josephch50/Wireless-Oscilloscope/0_Documentation/Oscilloscope Captures/Oscilloscope.jpg

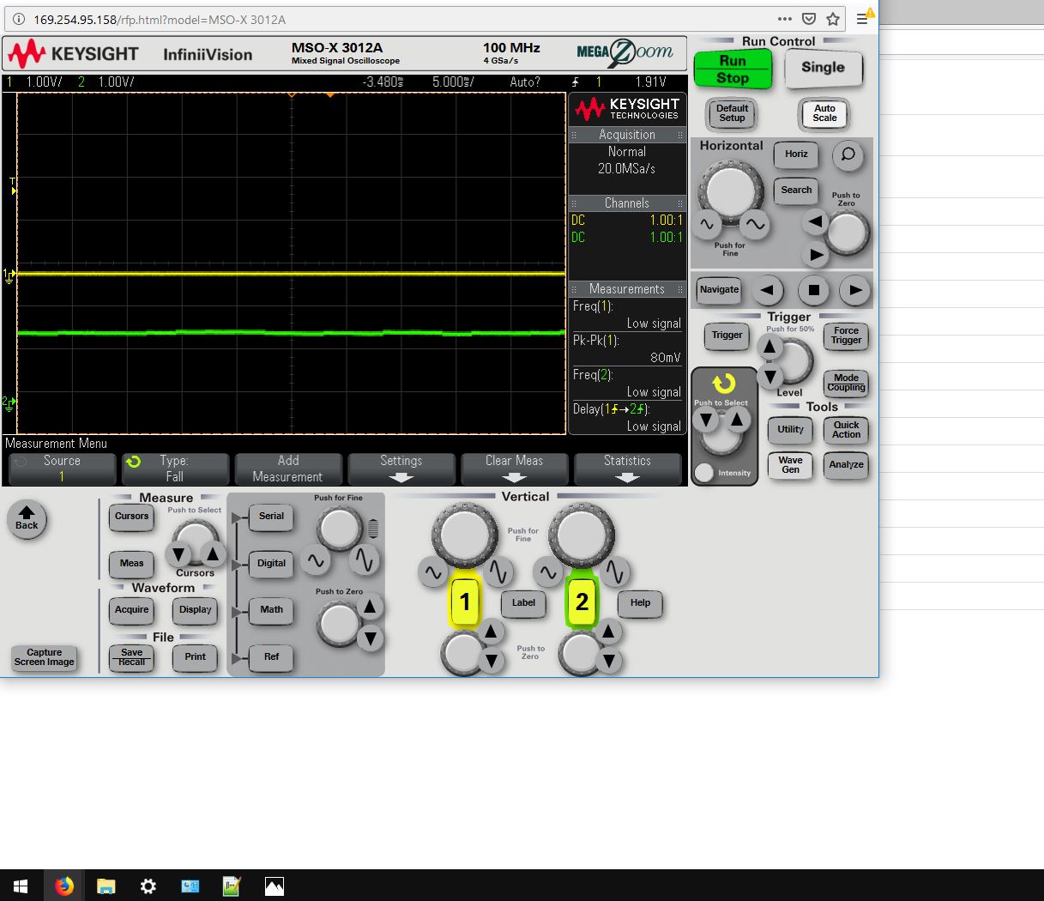
0_Documentation/Oscilloscope Captures/Oscilloscope.jpg
