josephch50/Wireless-Oscilloscope/README.md

# Wireless-Oscilloscope
Creating a wireless oscilloscope comprising of two TI MSP430F2274 development boards and AD5320 DAC

## Embedded Systems
## Team: Scope-A
## Contributors: Joseph Chen, Samuel Solverson, Andrew Kirkum

### Project Overview
The project will consist of building a Wireless Remote Oscilloscope Probe that uses two eZ430 cards, one for measuring the analog input signal and the other for reconstructing the analog signal using a digital to analog converter. As noted on the Final Project Specification[1] handout, the conditions for testing functionality include:
- Measure An input analog signal voltage ranging from 0 V to 3 V
- Input test signals of both sinusoidal and square waveforms
- Captures of both original and reconstructed signals on an oscilloscope
- A report, analyzing the performance of our project, including:
	- The lag time between the signals due to wireless system performance
	- The accuracy of the reconstructed signal compared to the original signal
	- The frequency bandwidth that the microcontroller can translate before significant distortion occurs in the reconstructed signal

### Testing
Required Software:
- IAR Embedded Workbench for MSP430
Required Hardware:
- (2) MSP430F2274 development boards and battery pack
- Oscilloscope
- Waveform Generator

### Testing Procedure
1. Download transmitter.c to one MSP430. This shall be the transmitter.
2. Download receiver.c to other MSP430. This shall be the receiver.
3. Wire MSP430 to the DAC. Wiring Diagrams are located in 0_Documentation.

### Acknowledgements
Thanks to our embedded systems professor, Roger Kieckhafer for helping us through this project.

### References
[1] R. M. Kieckhafer, _Final Project Specification_, 2019. [Online]. [Accessed 27 March 2019]. 

[2] _CC2500 - Low-Cost Low-Power 2.4 GHz RF Transceiver_, Texas Instruments, 2014.
[Online]. Available: cc2500-DS-2014.pdf. [Accessed 27 March 2019]. 

[3] _MSP430x2xx Family User's Guide_, Texas Instruments, 2013. [Online]. Available:
MSP430x2xx-Fam-UG.pdf. [Accessed 27 March 2019]. 

[4] _eZ430-RF2500 Development Tool User's Guide_, Texas Instruments, 2007. [Online].
Available: ez430-RF2500-UG.pdf. [Accessed 27 March 2019]. 

[5] _Mixed Signal Microcontroller - MSP430F22x4_, Texas Instruments, 2011. [Online].
Available: MSP430f2274-DS.pdf. [Accessed 27 March 2019]. 

[6] R. M. Kieckhafer, A. Majdara and S. G. Ayalew, _Lab-01: Introduction to IAR and GPIO_,
2019. 

[7] _2.7 V to 5.5 V, 140uA, Rail-to-Rail Output - 12-Bit DAC in an SOT-23 - AD5320_, Analog
Devices, 2007. [Online]. Available: DAC-SPI_AD5320-DS.pdf. [Accessed 27 March 2019]. 

[8] _Keysight 33220A 20 MHz Function/Arbitrary Waveform Generator_, Keysight Technologies
2007. [Online]. Available: http://literature.cdn.keysight.com/litweb/pdf/5988-8544EN.pdf.
[Accessed 27 March 2019]. 

[9] _Keysight InfiniiVision 3000 X-Series Oscilloscopes User Guide_, Keysight Technologies,
2013. [Online]. Available: http://literature.cdn.keysight.com/litweb/pdf/75019-97073.pdf.
[Accessed 27 March 2019]. 

[10] R. M. Kieckhafer and P. Ramesh, _Lab-08: Wireless Comm via the cc2500_, 2019. 

[11] R. M. Kieckhafer and P. Ramesh, _Lab-06: MSP430 to DAC Chip via SPI_, 2019.
17 

[12] R. M. Kieckhafer, S. G. Ayalew and J. Tan, _Lab-04: MSP430 - ADC10 Converter_, 2019. 

[13] R. M. Kieckhafer, _Written Document Style Guide_, 2017. [Online]. [Accessed 27 March
2019]. 

[14] R. M. Kieckhafer, _Embedded Programming Style Guide_, 2015. [Online]. [Accessed 27
March 2019].
