josephch50/Wireless-Oscilloscope/0_Documentation/Oscilloscope Captures/1Hz -500mV to  3.3V Sine.png

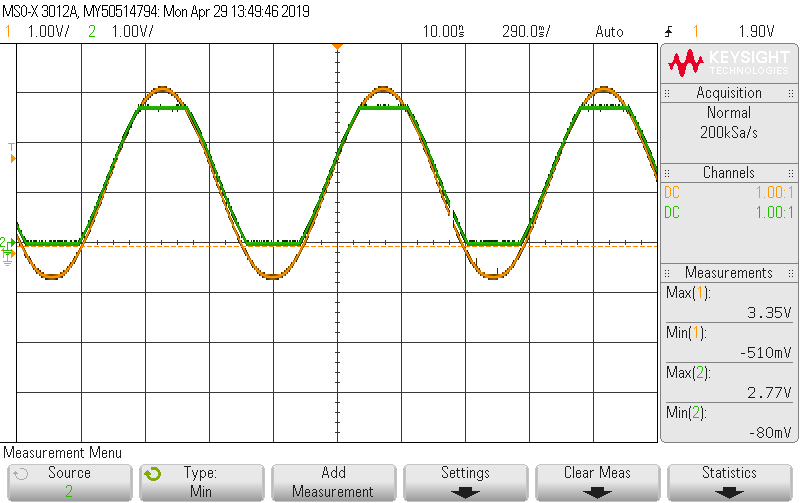
0_Documentation/Oscilloscope Captures/1Hz -500mV to 3.3V Sine.png
