josephch50/Wireless-Oscilloscope/0_Documentation/Oscilloscope Captures/25Hz 2.7V Sine.png

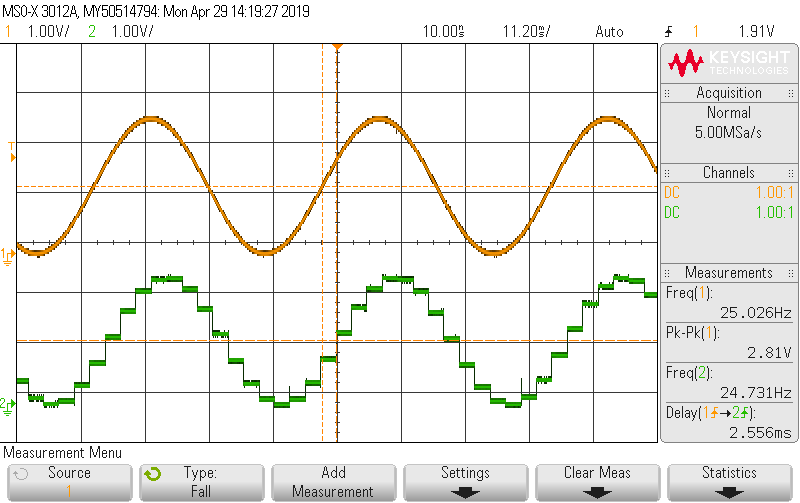
0_Documentation/Oscilloscope Captures/25Hz 2.7V Sine.png
