josephch50/Wireless-Oscilloscope/0_Documentation/Oscilloscope Captures/45Hz 2.7 Sine.png

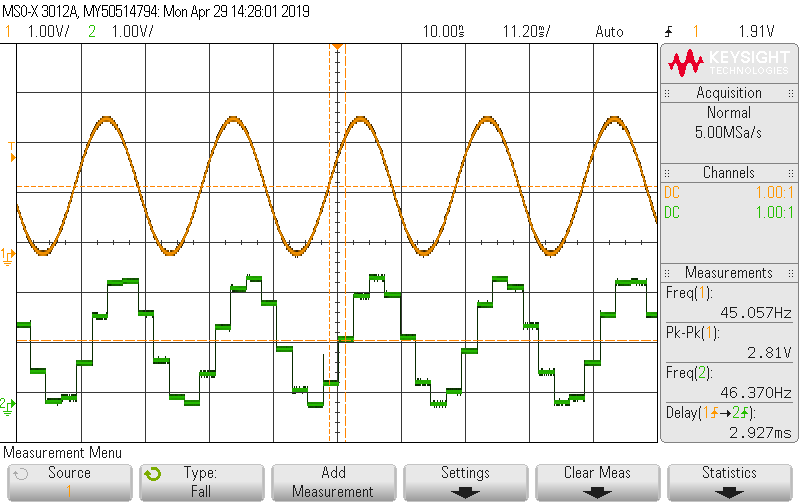
0_Documentation/Oscilloscope Captures/45Hz 2.7 Sine.png
