josephch50/Wireless-Oscilloscope/0_Documentation/Oscilloscope Captures/185Hz 2.7 Sine (cursor).png

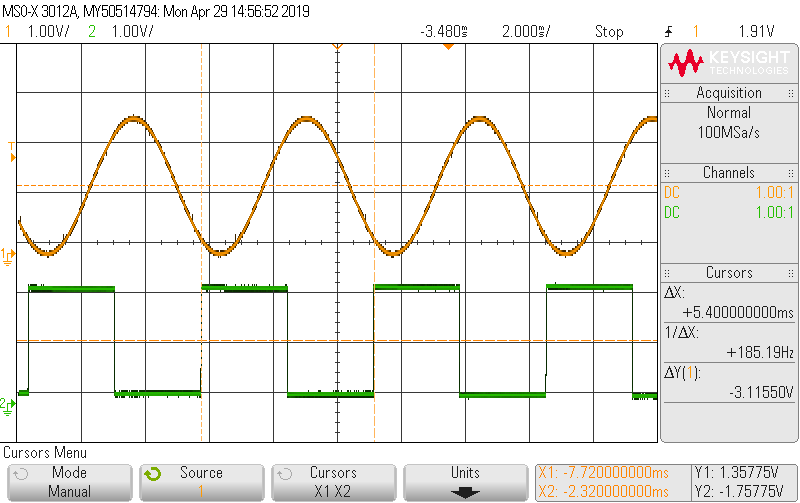
0_Documentation/Oscilloscope Captures/185Hz 2.7 Sine (cursor).png
