josephch50/Wireless-Oscilloscope/0_Documentation/Oscilloscope Captures/285Hz 2.7 Square.png

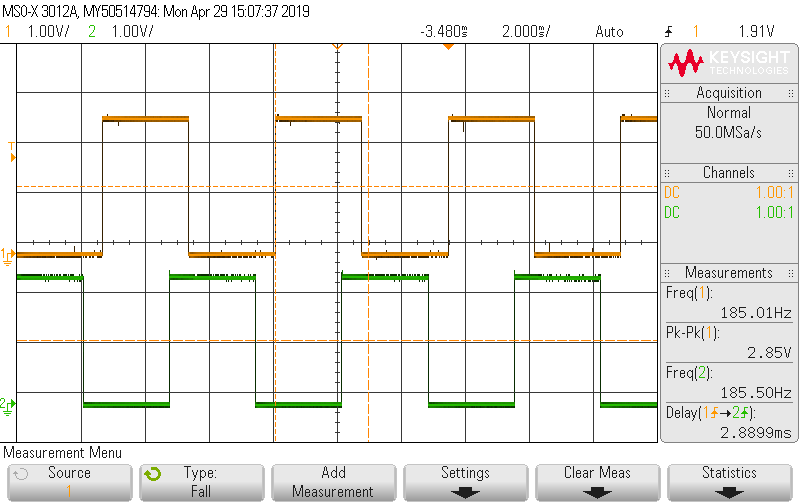
0_Documentation/Oscilloscope Captures/285Hz 2.7 Square.png
