josephch50/Wireless-Oscilloscope/0_Documentation/Wiring Diagram/MSP430 for Single Chip .png

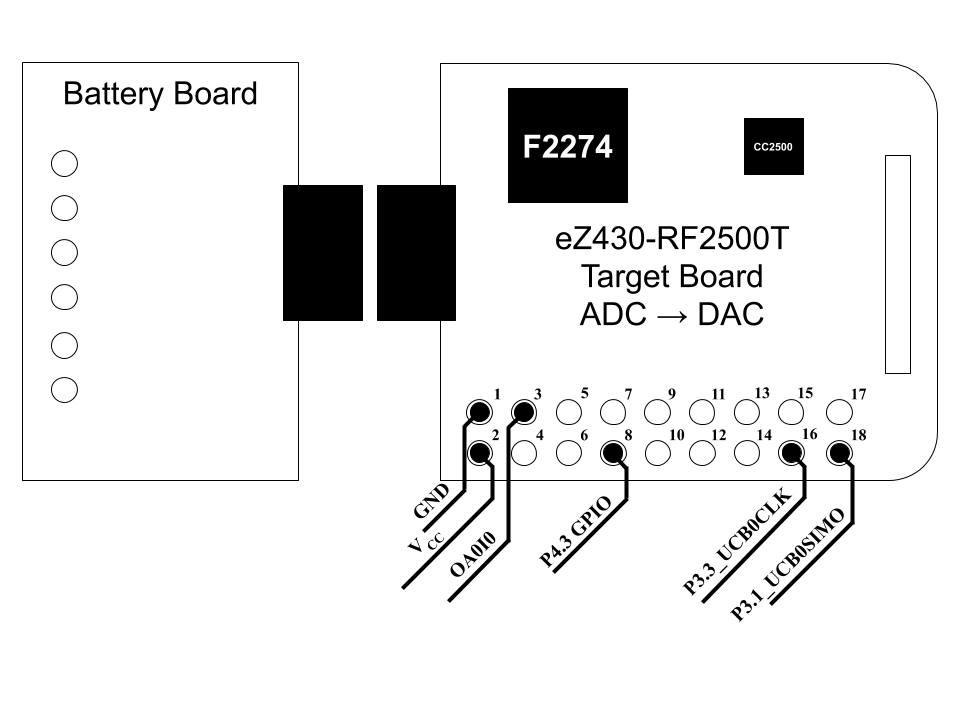
0_Documentation/Wiring Diagram/MSP430 for Single Chip .png
