josephch50/Wireless-Oscilloscope/0_Documentation/Wiring Diagram/MSP430 Transmitter.png

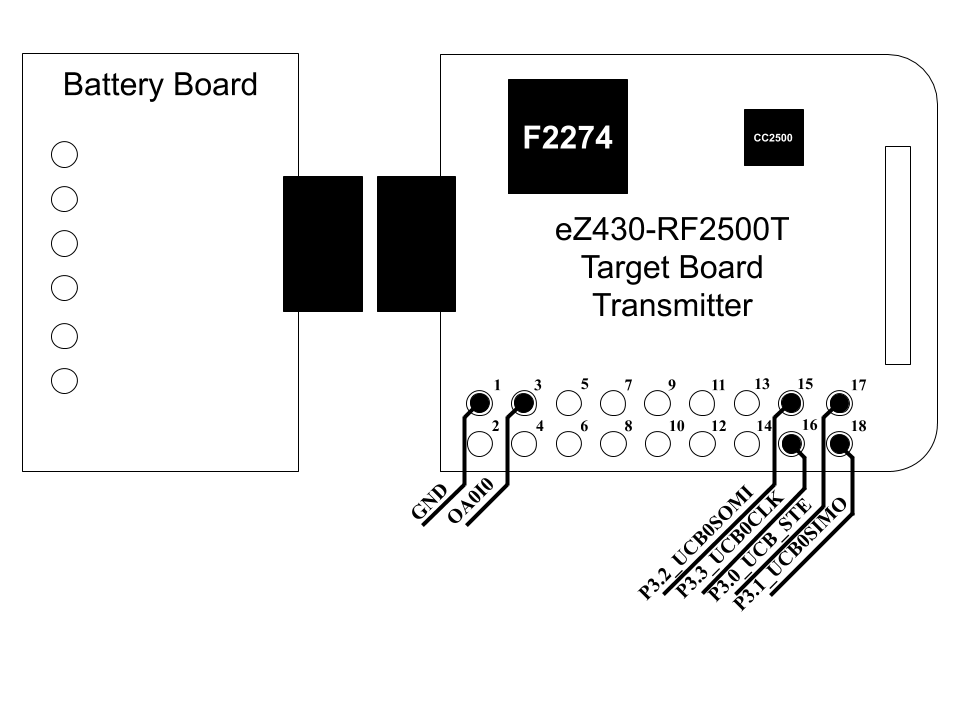
0_Documentation/Wiring Diagram/MSP430 Transmitter.png
